Moh-Snoussi/microcontroller-smart-dimmer/ref/3d_card.JPG

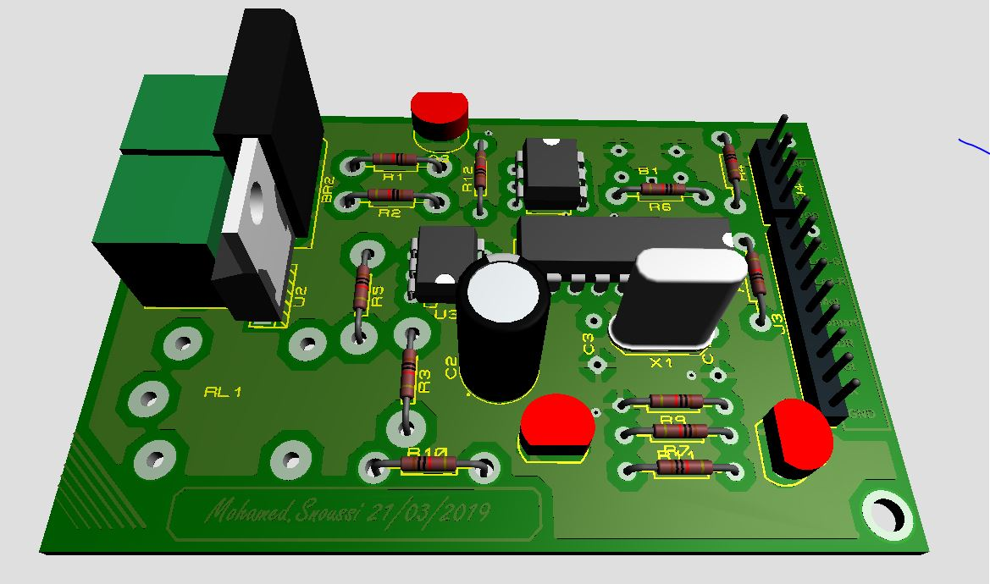
ref/3d_card.JPG
