Moh-Snoussi/microcontroller-smart-dimmer/ref/back3d.JPG

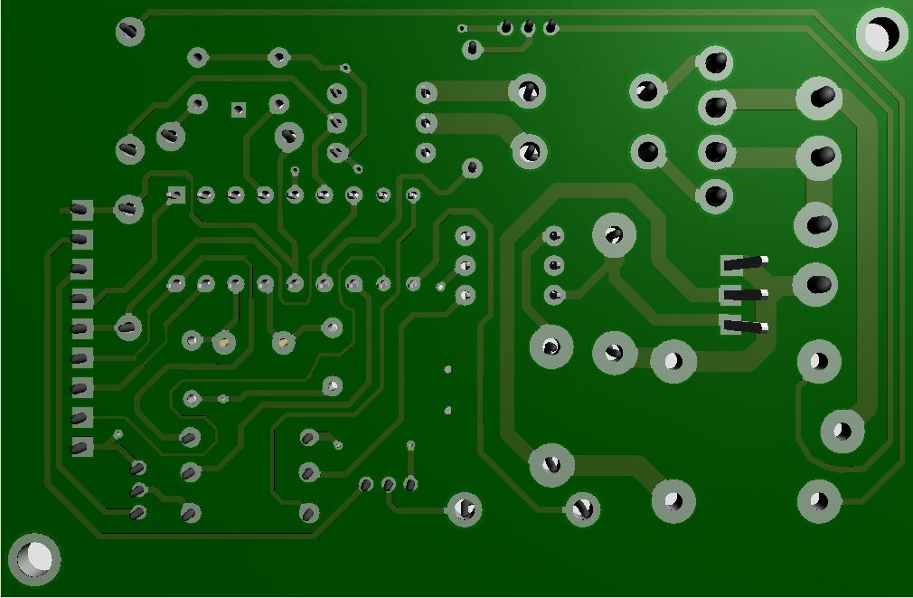
ref/back3d.JPG
