Moh-Snoussi/microcontroller-smart-dimmer/ref/circuit_front_git.JPG

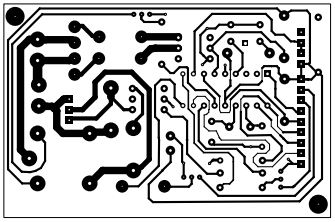
ref/circuit_front_git.JPG
