Moh-Snoussi/microcontroller-smart-dimmer/ref/circuit_git.JPG

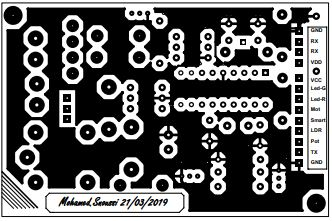
ref/circuit_git.JPG
