Moh-Snoussi/microcontroller-smart-dimmer/ref/schematic.pdf

J1

X1

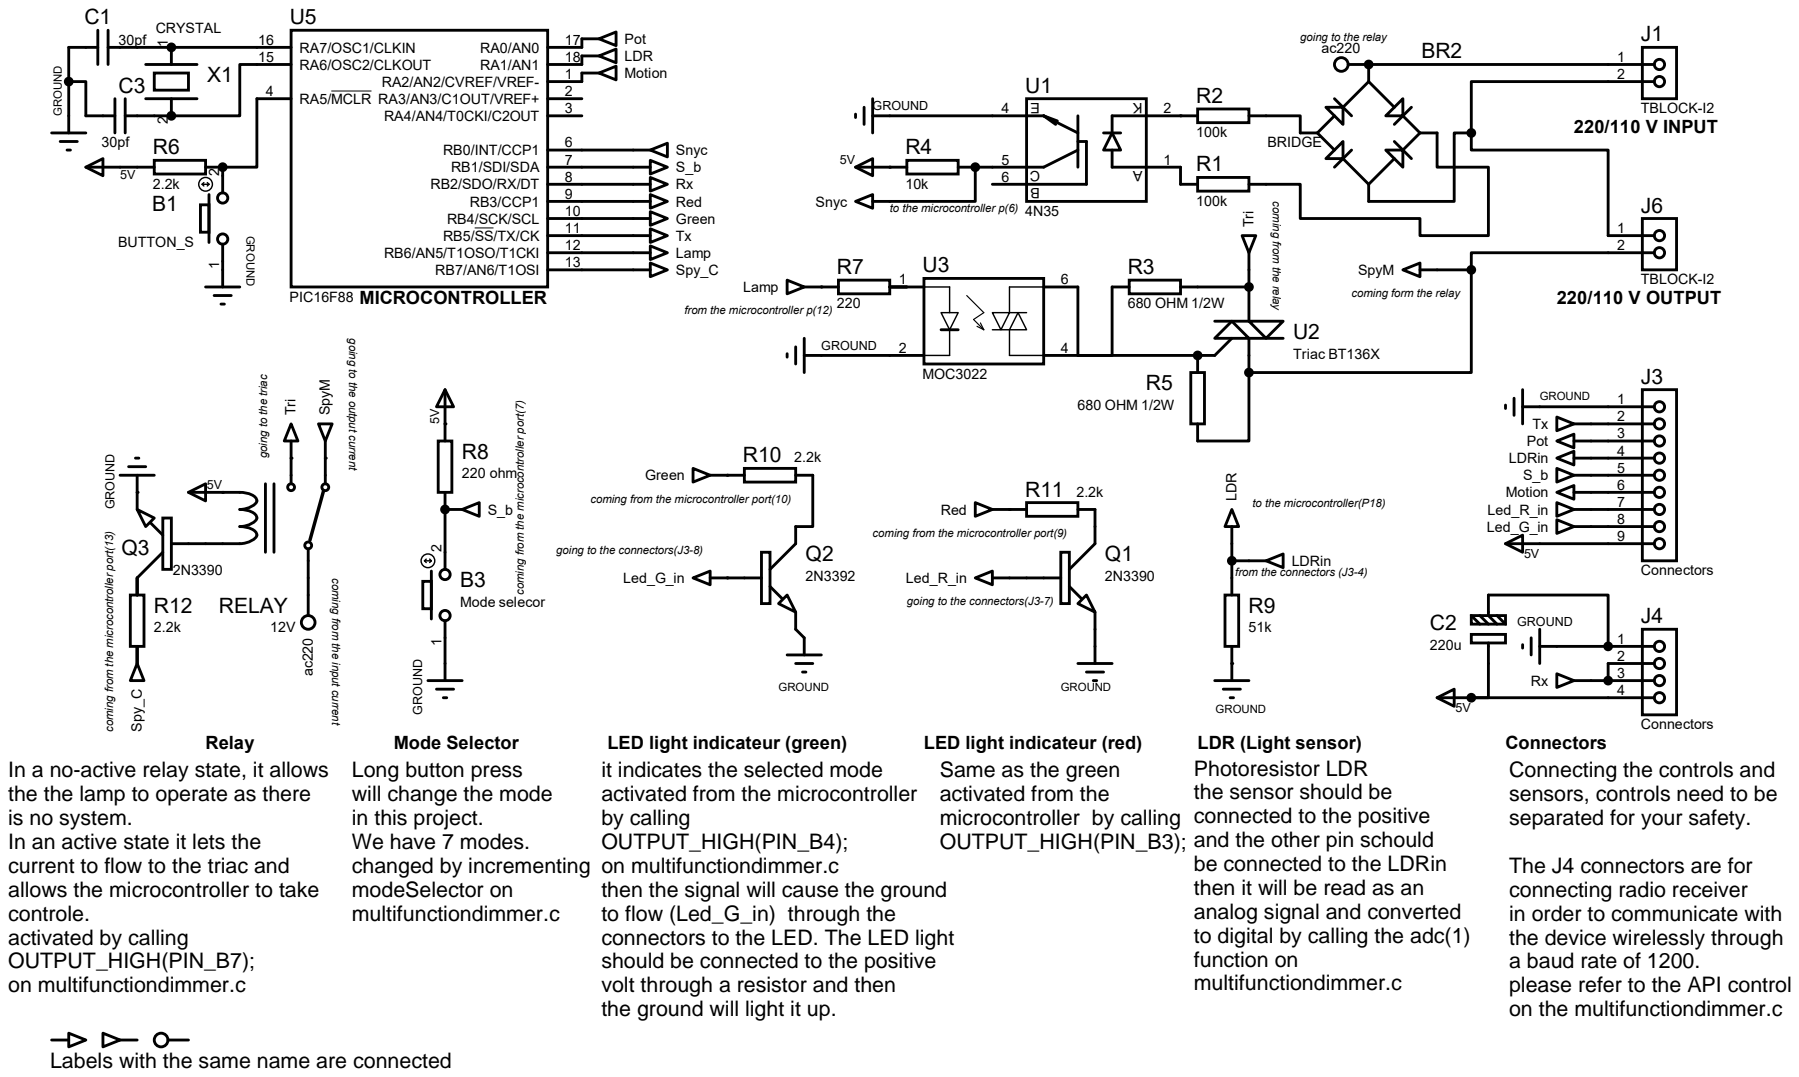
[picture p6: page 1]

going to the relay

coming from the relay

going to the output current

going to the triac

coming from the microcontroller port(7)

coming from the microcontroller port(10)

coming from the microcontroller port(13)

coming from the microcontroller port(9)

going to the connectors(J3-8)

coming from the input current

going to the connectors(J3-7)
