Moh-Snoussi/microcontroller-smart-dimmer/ref/PCB(bottom).PDF

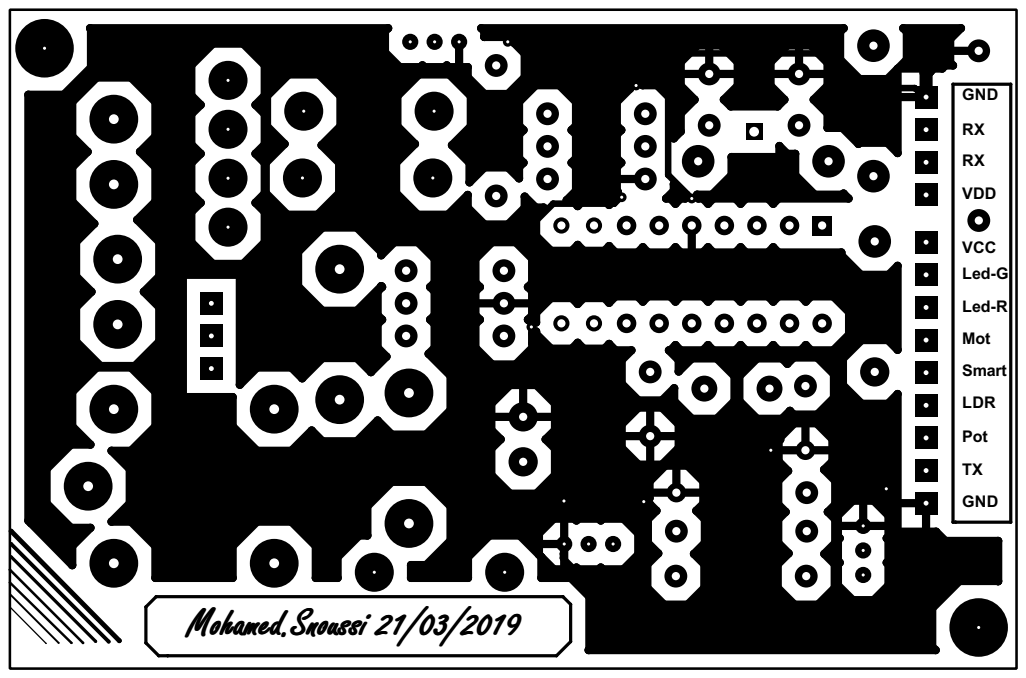
[picture p7: page 1]

VCC
Led-G
Led-R Mot Smart LDR
