Moh-Snoussi/microcontroller-smart-dimmer/ref/PCB(top).PDF

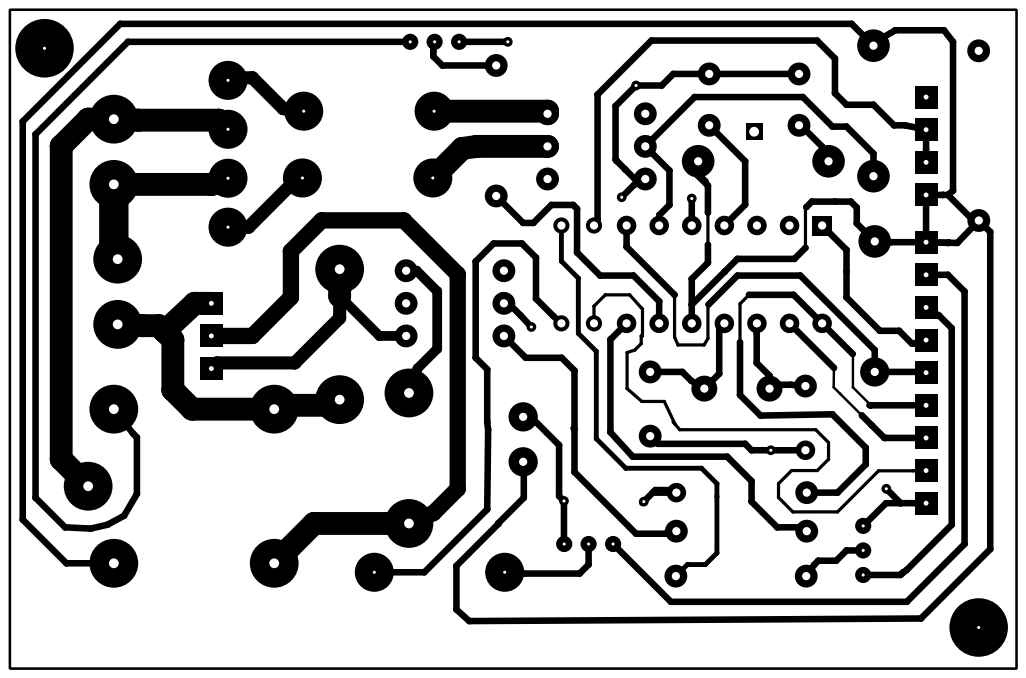
[picture p8: page 1]
