Moh-Snoussi/microcontroller-smart-dimmer/(list of files, drawings)

Other design files:
ref/Plac gradateur.pdsprj
