Moh-Snoussi/microcontroller-smart-dimmer/projectHeaders.h

#include <16F88.h>
#device ADC=8

#FUSES NOWDT                    //No Watch Dog Timer
#FUSES NOBROWNOUT               //No brownout reset
#FUSES NOLVP                    //No low voltage prgming, B3(PIC16) or B5(PIC18) used for I/O

#use delay(crystal=20000000)
#use rs232(UART1,baud=1200,errors)
