Moh-Snoussi/microcontroller-smart-dimmer/(commit log)

2019-03-29 circuit and improving README.md
    [Plac gradateur.pdsprj]
2019-03-30 Improving README
    [Plac gradateur.pdsprj]
